PatrikBichis/openhead-desktop-body/docs/media/hardware/hero.jpg

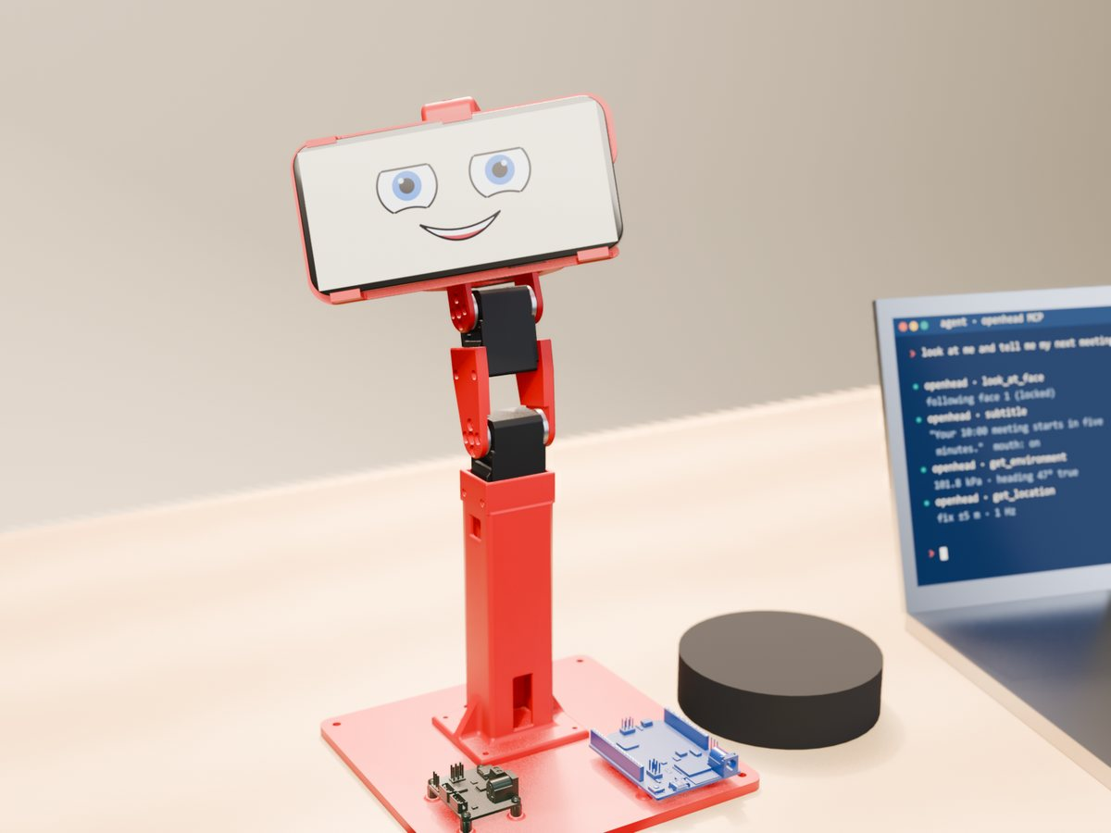
docs/media/hardware/hero.jpg
