PatrikBichis/openhead-desktop-body/hardware/images/back.png

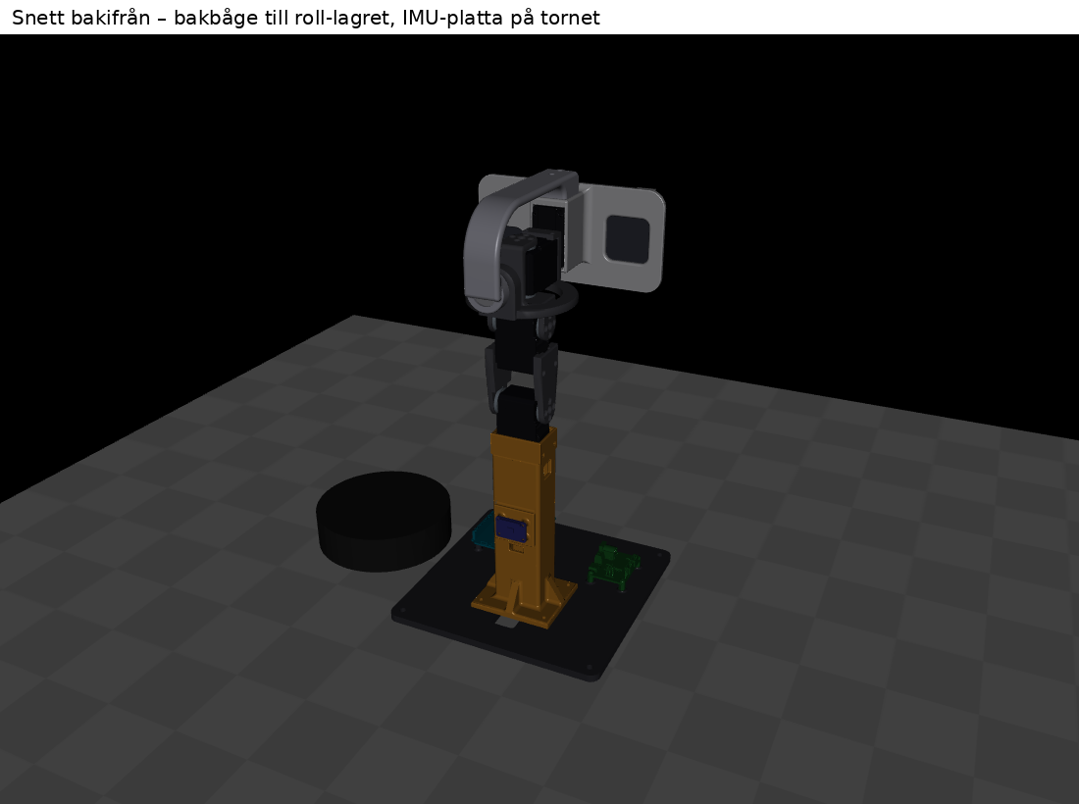
hardware/images/back.png
