PatrikBichis/openhead-desktop-body/hardware/images/electronics.png

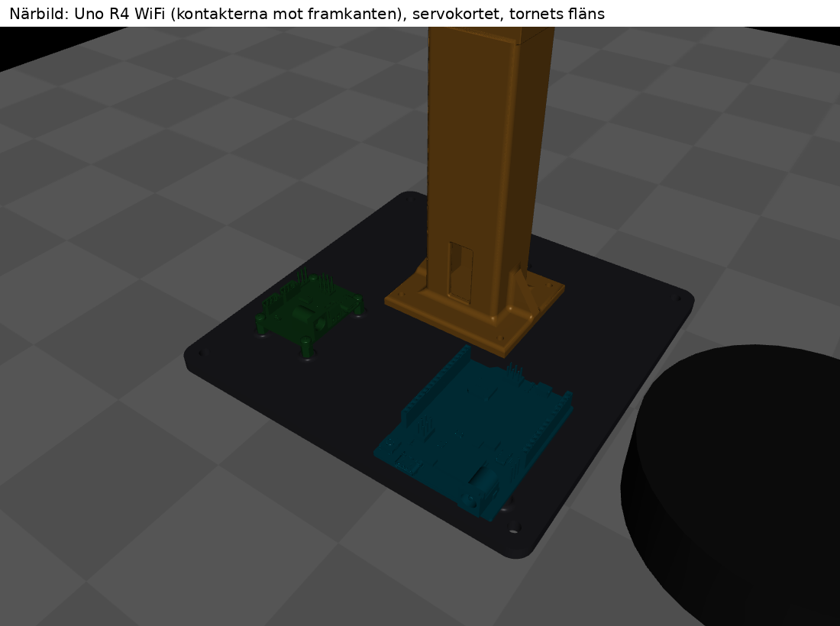
hardware/images/electronics.png
