PatrikBichis/openhead-desktop-body/hardware/images/front.png

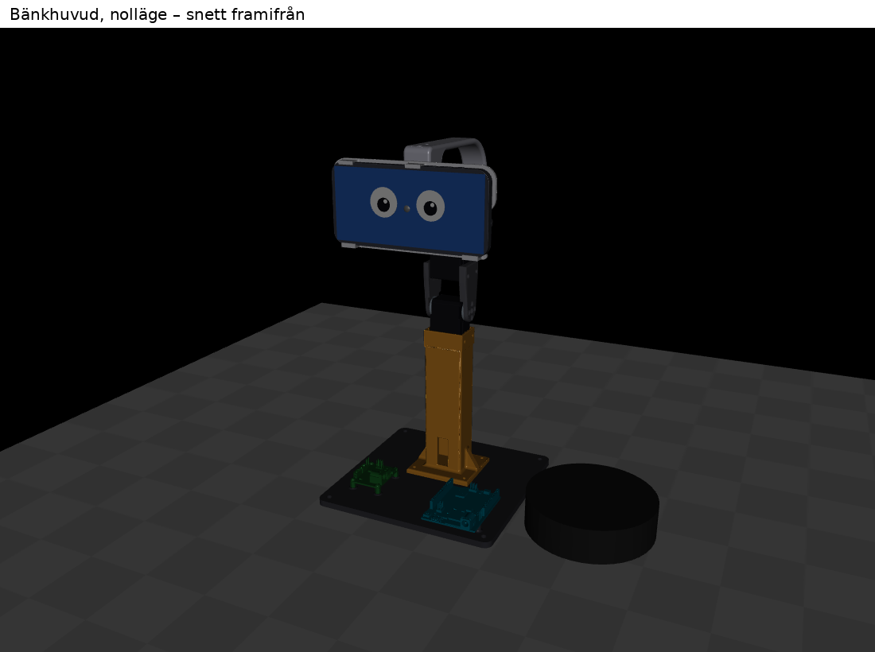
hardware/images/front.png
