PatrikBichis/openhead-desktop-body/hardware/images/phone_fit.png

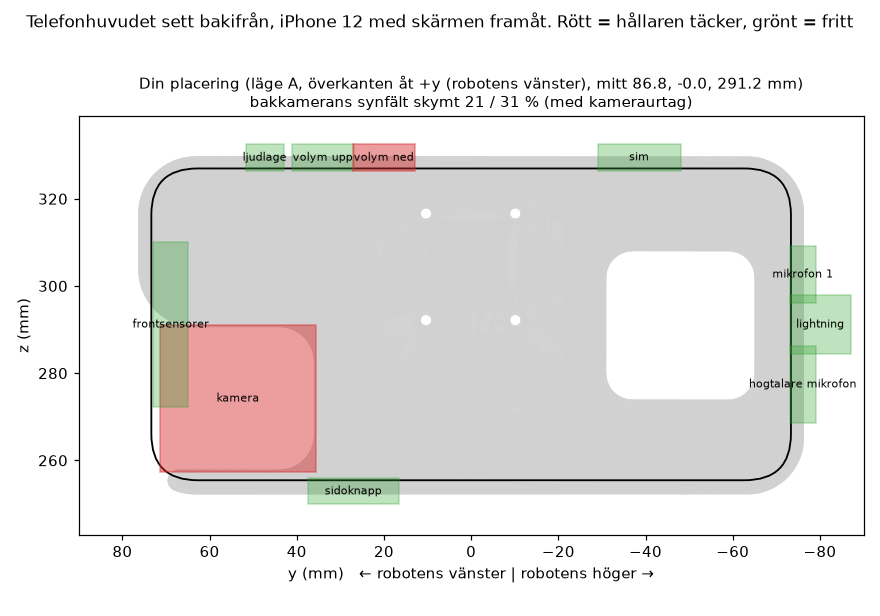
hardware/images/phone_fit.png
