PatrikBichis/openhead-desktop-body/hardware/images/side.png

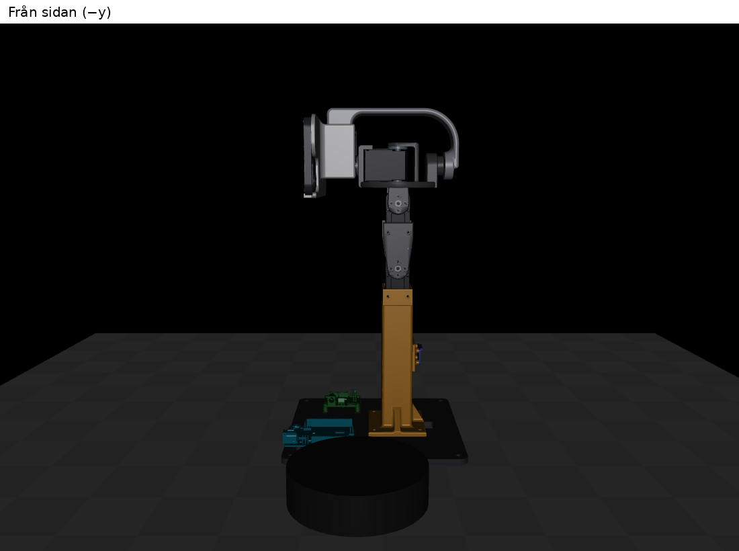
hardware/images/side.png
