PatrikBichis/openhead-desktop-body/hardware/images/tpu_dampers.png

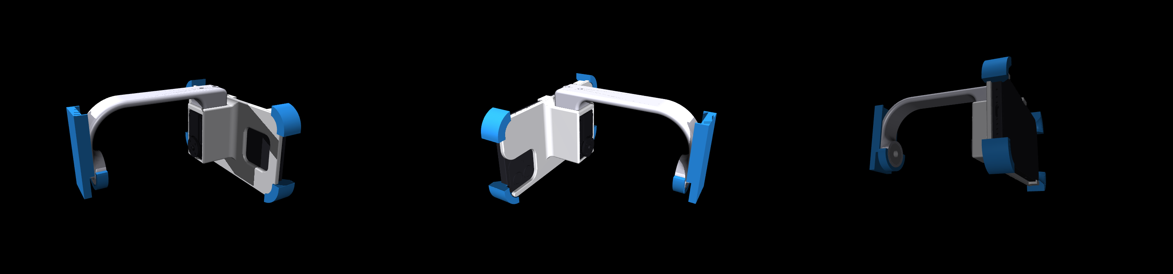
hardware/images/tpu_dampers.png
