PatrikBichis/openhead-desktop-body/hardware/assembly/desk_body_assembly.step

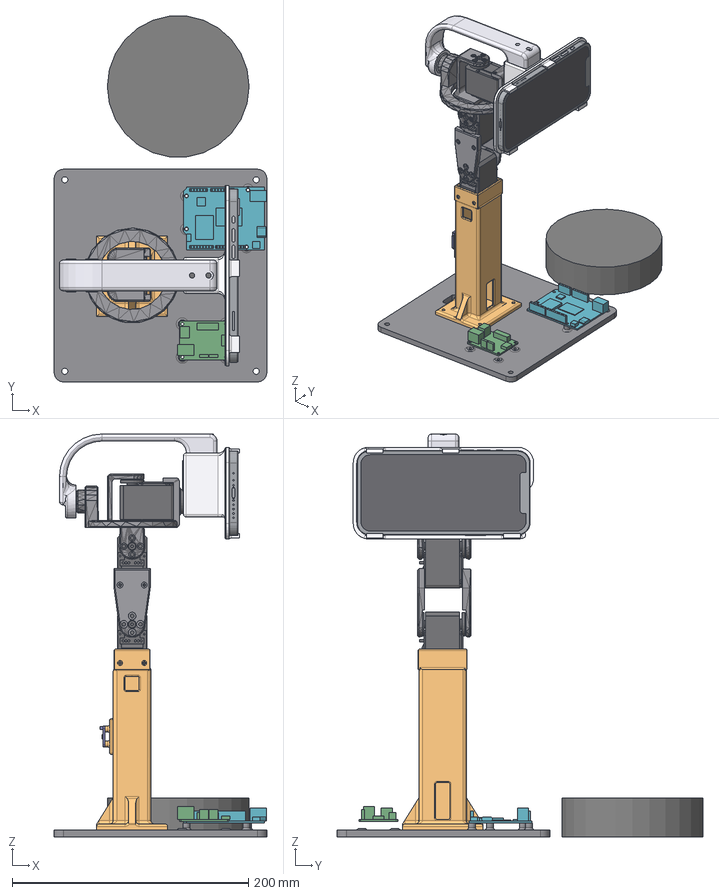
[picture p14: CAD file, 2026-11-01]
hardware/assembly/desk_body_assembly.step
180.0 x 309.6 x 341.0 mm
bas
torn
servo_neck_pitch_servo
uno_r4_wifi_kort
uno_r4_wifi_stiftlister
uno_r4_wifi_usb_c
uno_r4_wifi_dc_uttag
uno_r4_wifi_esp32_s3_modul
uno_r4_wifi_led_matris
uno_r4_wifi_ra4m1
uno_r4_wifi_qwiic
uno_r4_wifi_reset
servoadapter_kort
servoadapter_dc_uttag_5_5x2_1
servoadapter_skruvplint
servoadapter_usb_c
servoadapter_servokontakter
servoadapter_uart_stift
servoadapter_lagesbygel
bno085_kort
bno085_bno085
bno085_stift
servo_head_pitch_servo
servo_head_yaw_servo
neck_left_sheet_neck_left_sheet
neck_right_sheet_neck_right_sheet
head_pitch_to_yaw_head_pitch_to_yaw
head_yaw_to_roll_lager_head_yaw_to_roll_lager
telefonhuvud
bakbage
servo_head_roll_servo
roll_lager_lager
iphone12_kropp
iphone12_skarm
iphone12_kameraon
iphone12_kamera_1_ring
iphone12_kamera_1_lins
iphone12_kamera_2_ring
iphone12_kamera_2_lins
iphone12_blixt
iphone12_knapp_ljudlage
iphone12_knapp_volym_upp
iphone12_knapp_volym_ned
iphone12_knapp_sidoknapp
jabra_speak_510_hogtalare
