PatrikBichis/openhead-desktop-body/hardware/print/neck_left_sheet.stl

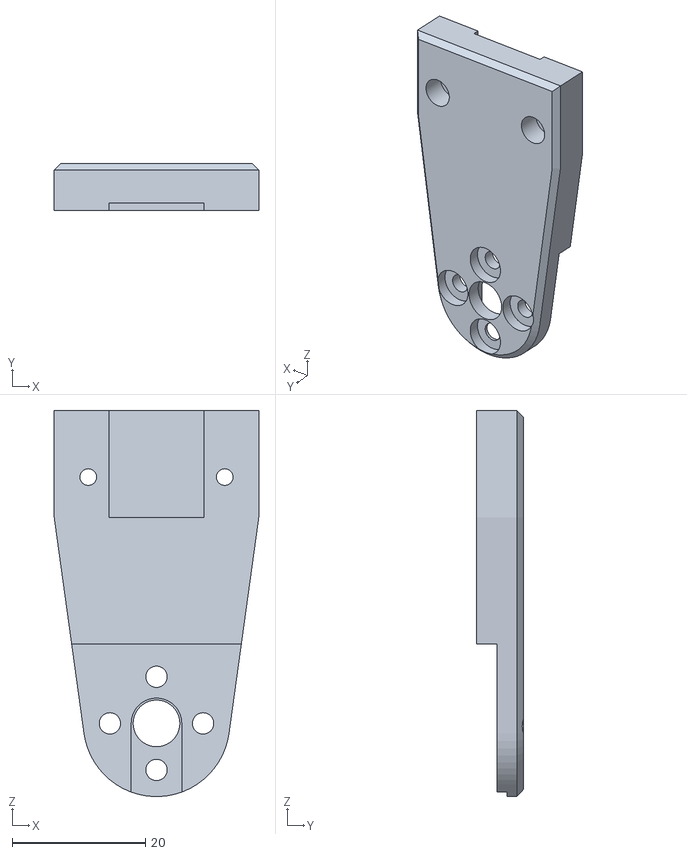
[picture p15: CAD file, 2026-11-01]
hardware/print/neck_left_sheet.stl
30.7 x 7.05 x 58.0
