PatrikBichis/openhead-desktop-body/hardware/print/tpu_corner_left_lower.step

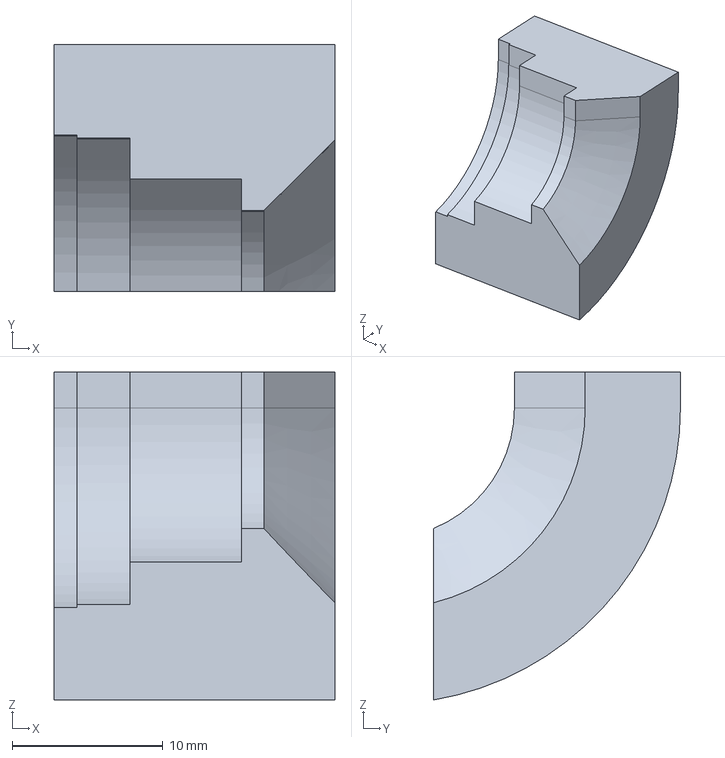
[picture p16: CAD file, 2026-11-01]
hardware/print/tpu_corner_left_lower.step
18.6 x 16.4 x 21.7 mm
