PatrikBichis/openhead-desktop-body/hardware/print/head_pitch_to_yaw.stl

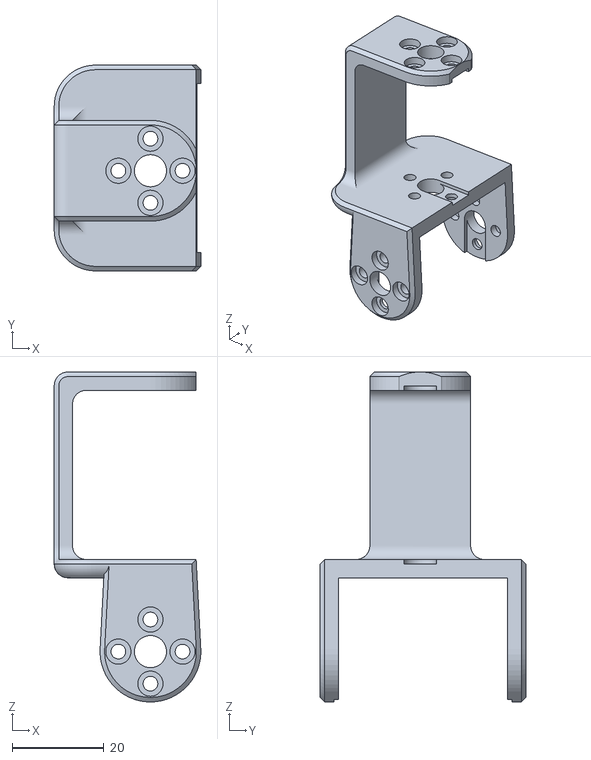
[picture p17: CAD file, 2026-11-01]
hardware/print/head_pitch_to_yaw.stl
32.0 x 44.9 x 72.0
