PatrikBichis/openhead-desktop-body/hardware/print/head_yaw_to_roll_bearing.stl

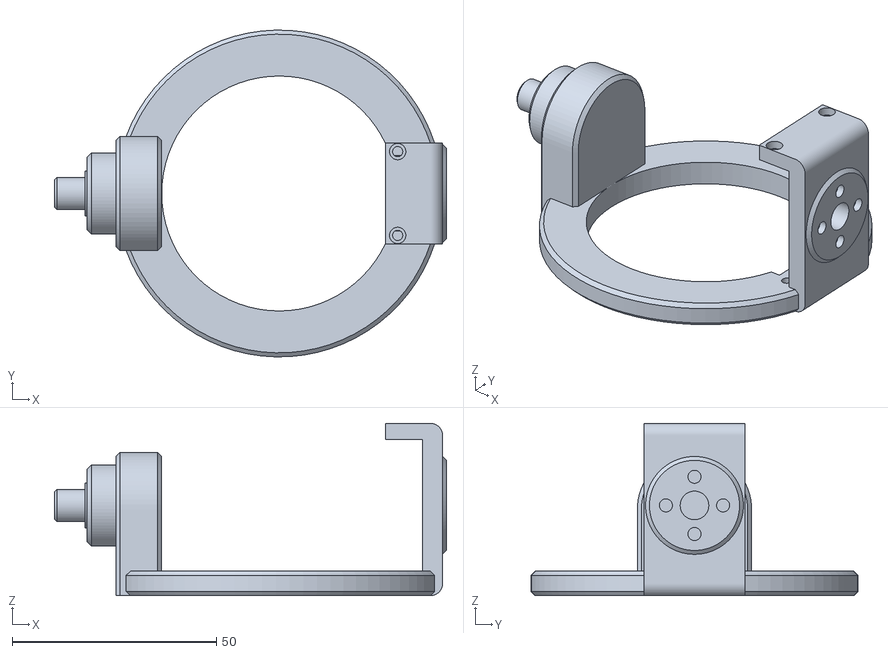
[picture p18: CAD file, 2026-11-01]
hardware/print/head_yaw_to_roll_bearing.stl
96.0 x 80.0 x 42.2
