PatrikBichis/openhead-desktop-body/hardware/print/rear_arch.step

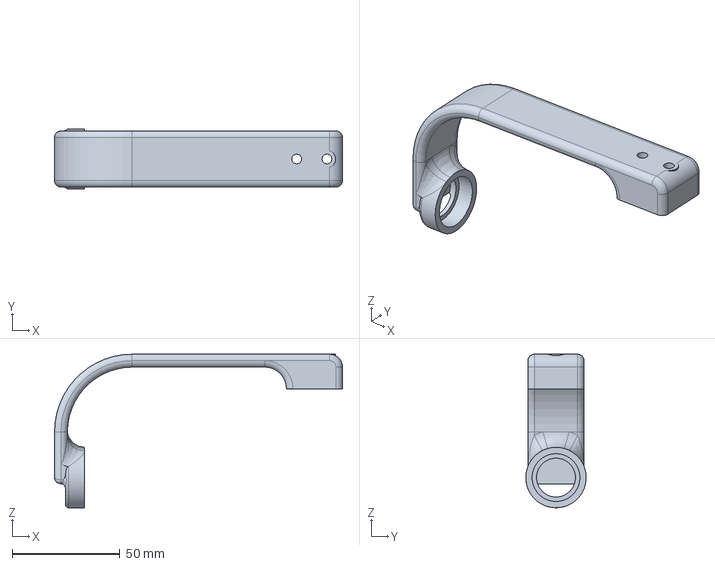
[picture p19: CAD file, 2026-11-01]
hardware/print/rear_arch.step
133.4 x 28.0 x 71.1 mm
