PatrikBichis/openhead-desktop-body/hardware/print/tpu_rear_pad.step

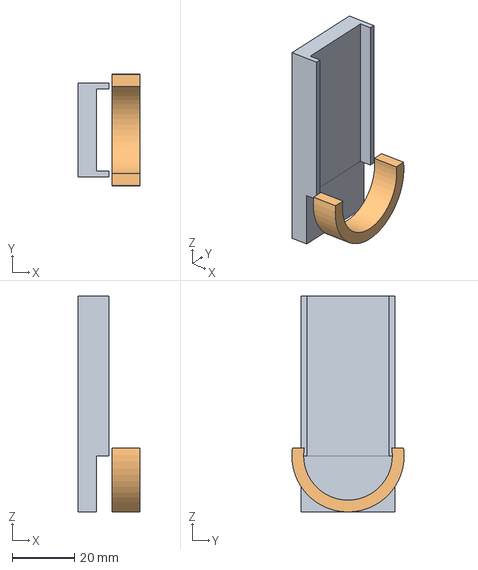
[picture p20: CAD file, 2026-11-01]
hardware/print/tpu_rear_pad.step
20.0 x 36.0 x 69.1 mm
