PatrikBichis/openhead-desktop-body/hardware/print/neck_right_sheet.stl

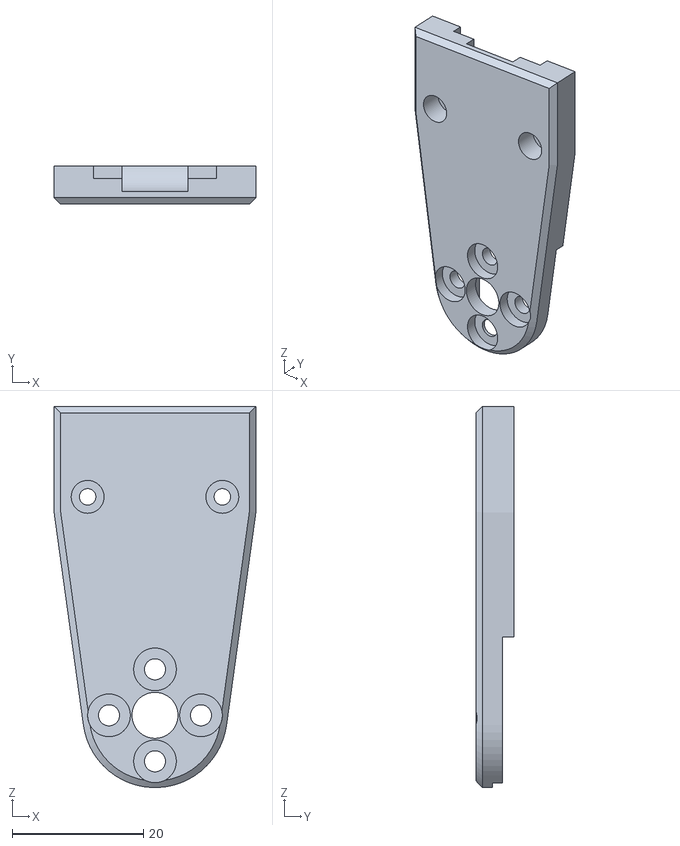
[picture p21: CAD file, 2026-11-01]
hardware/print/neck_right_sheet.stl
30.7 x 5.85 x 58.0
