PatrikBichis/openhead-desktop-body/hardware/print/phone_holder.step

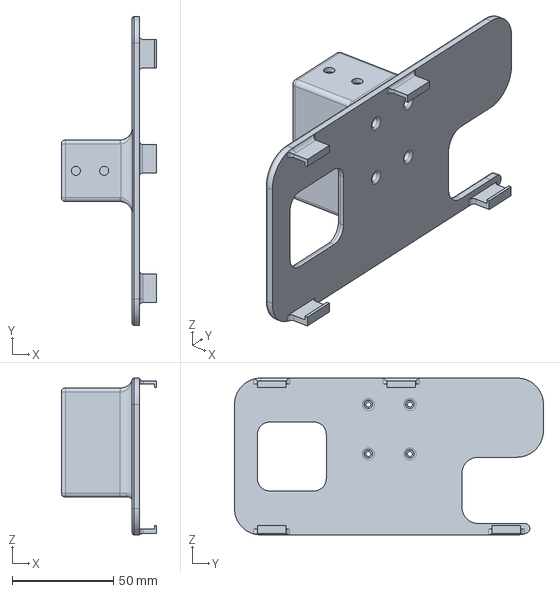
[picture p22: CAD file, 2026-11-01]
hardware/print/phone_holder.step
47.2 x 152.7 x 77.5 mm
