PatrikBichis/openhead-desktop-body/hardware/print/tpu_foot_pad.stl

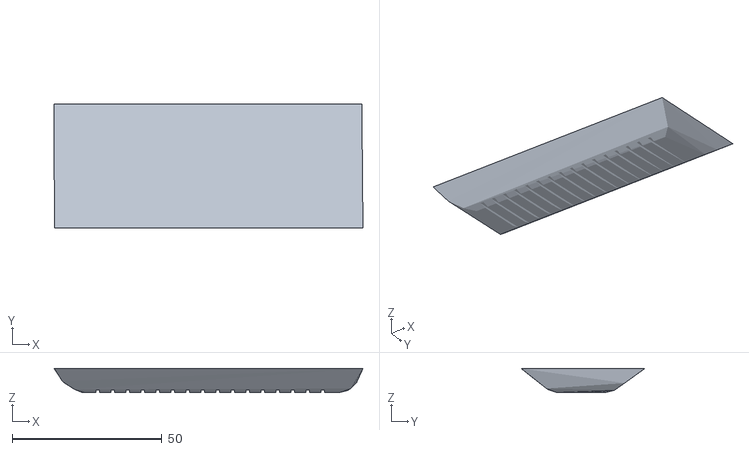
[picture p24: CAD file, 2026-11-01]
hardware/print/tpu_foot_pad.stl
103.1 x 41.3 x 8.01
