PatrikBichis/openhead-desktop-body/hardware/print/tower.step

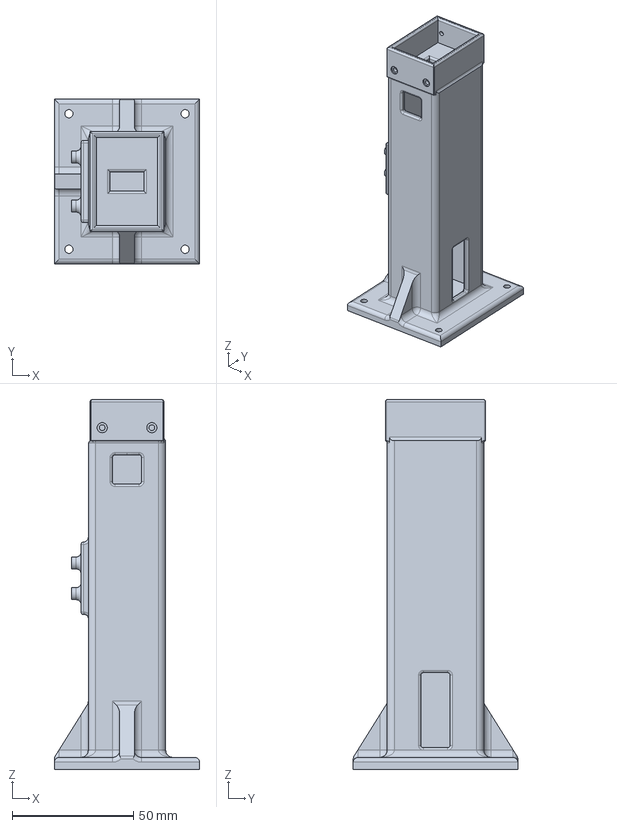
[picture p25: CAD file, 2026-11-01]
hardware/print/tower.step
60.0 x 68.0 x 152.9 mm
