PatrikBichis/openhead-desktop-body/hardware/print/zero_jig_neck_pitch.step

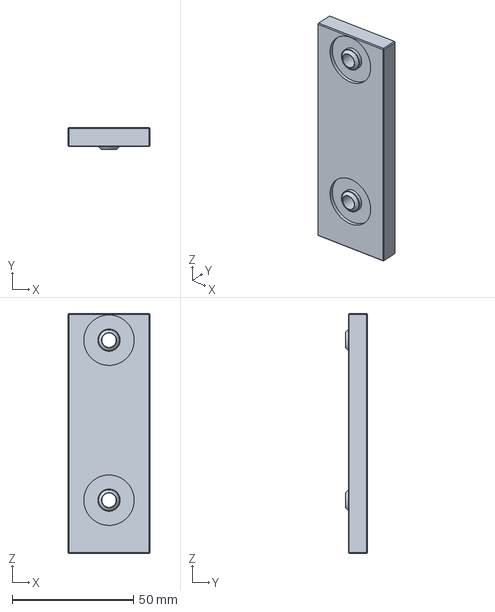
[picture p26: CAD file, 2026-11-01]
hardware/print/zero_jig_neck_pitch.step
34.0 x 9.20 x 99.0 mm
