PatrikBichis/openhead-desktop-body/hardware/print/base.step

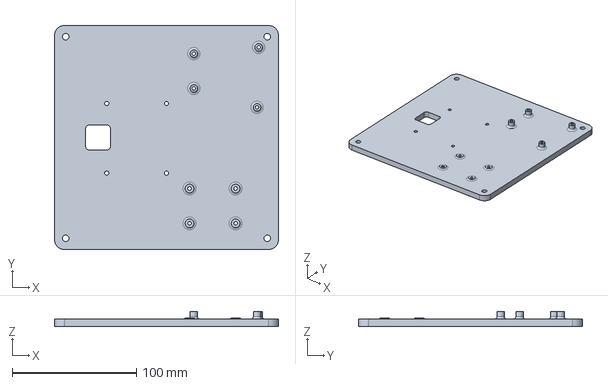
[picture p27: CAD file, 2026-11-01]
hardware/print/base.step
180.0 x 180.0 x 12.0 mm
