PatrikBichis/openhead-desktop-body/(list of files, cad)

Other CAD files:
hardware/print/tpu_corner_right_upper.step
hardware/print/tpu_corner_right_lower.step
hardware/print/base.stl
hardware/print/phone_holder.stl
hardware/print/rear_arch.stl
hardware/print/tower.stl
hardware/print/tpu_corner_left_lower.stl
hardware/print/tpu_corner_left_upper.stl
hardware/print/tpu_corner_right_lower.stl
hardware/print/tpu_corner_right_upper.stl
hardware/print/tpu_rear_pad.stl
hardware/print/zero_jig_neck_pitch.stl
