PatrikBichis/openhead-desktop-body/(commit log)

2026-11-01 OpenHead desk body: Open Duck Mini's neck holding an iPhone
    The body under OpenHead: printed parts (a phone holder, a tower, a base and a rear
    arch, plus Open Duck Mini v2's neck parts), the whole rig as a STEP assembly, the
    Uno R4 WiFi firmware (servo setup and the 50 Hz body firmware with watchdog), and
    the Python package openhead_body: the bench and calibration tools from the Open
    Duck bench work, a neck controller (look, gestures, minimum-jerk moves, the 50 Hz
    loop the watchdog needs), face following through OpenHead's faces stream, a CLI
    and an MCP server. 46 tests run against a simulated Uno.
    The neck design is Open Duck Mini v2's (Apache 2.0), adapted to hold a phone.
    Co-Authored-By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
    [base.step, base.stl, desk_body_assembly.step, head_pitch_to_yaw.stl, head_yaw_to_roll_bearing.stl, neck_left_sheet.stl, neck_right_sheet.stl, phone_holder.step]
2026-11-03 Desk film: Open Duck Mini with its servos and both feet
